kerby2000/SnookerHelpCueTracker/PCB/CueTracker/docs/hardware/source_register.md

# Cue Tracker hardware primary-source register

Date: 2026-07-15

This register records the manufacturer sources used for the hierarchical `rear_main.kicad_sch` / `front_sensor.kicad_sch` design: pin maps, support networks, footprints, protection thresholds, power limits and provisional tuning values.

| Block | Primary source | Applied decision |
|---|---|---|
| ESP32-S3-PICO-1-N8R8 | https://documentation.espressif.com/esp32-s3-pico-1_datasheet_en.pdf | Official LGA56 plus exposed-pad pin map and 7 x 7 mm package; 8 MB Quad-SPI flash, 8 MB Octal-SPI PSRAM, 40 MHz crystal and SiP RF matching are integrated. The external W25Q128 and external 40 MHz network are removed. `-N8R8` ambient rating is -40 to +65 C unless PSRAM ECC is deliberately enabled under Espressif's stated conditions |
| ESP32-S3-PICO-1 CAD provenance | https://github.com/espressif/kicad-libraries | The user-supplied `ESP32-S3-PICO-1-N8R2.zip` was used only for package/STEP geometry common to the PICO-1 family. N8R2 electrical metadata must not be copied into the N8R8 symbol. The project footprint is `CueTracker_Exact:Espressif_ESP32-S3-PICO-1_LGA56_7x7mm_P0.4mm` and the project model is `CueTracker.3dshapes/ESP32-S3-PICO-1-LGA56.step`; pinout and ordering data come from the official N8R8 data sheet |
| ESP32-S3 hardware guidance | https://docs.espressif.com/projects/esp-hardware-design-guidelines/en/latest/esp32s3/schematic-checklist.html | At-least-500-mA 3.3 V source requirement, main-entry bulk capacitance, CHIP_PU/BOOT, native USB and RF layout checks. SiP-specific pin and peripheral implementation remains governed by the PICO-1 data sheet |
| USB data ESD | https://www.st.com/resource/en/datasheet/usblc6-2.pdf | Retained USBLC6-2SC6 dual-line protection on the ESP32-owned USB D+/D- pair. Place it connector-adjacent with short, symmetric data routing and a low-inductance Earth path; do not substitute the earlier PESD5V0Y1BCSF entry without revisiting the symbol, footprint and signal-integrity review |
| VBUS ESD | https://www.ti.com/lit/ds/symlink/esd441.pdf | ESD441-class unidirectional 5 V TVS placed directly beside the USB-C receptacle, before the eFuse, with a short Earth discharge path |
| USB input eFuse/current limiter | https://www.ti.com/lit/ds/symlink/tps25947.pdf | TPS259470A-class reverse-blocking eFuse ahead of BQ25611D. `RILM = 1.10 kOhm`, 1%, targets approximately 3.0 A nominal by TI's programming relation. Validate the exact installed variant, limit tolerance, dV/dt/inrush network, fault timer and thermal response. No 500 mA PPTC remains |
| USB-C CC ESD | https://www.ti.com/lit/ds/symlink/tpd2e2u06.pdf | TPD2E2U06-class dual low-capacitance protection on CC1 and CC2, placed connector-adjacent; it does not replace the TUSB320LAI CC detector |
| TPS63802DLAR | https://www.ti.com/lit/ds/symlink/tps63802.pdf | U5 DLA0010A pin map, true buck-boost topology, 2 A at 3.3 V for input at or above 2.3 V, 0.47 uH, input/output capacitance, feedback and PG implementation |
| TPS63802 power inductor | https://www.coilcraft.com/getmedia/84927b8b-f089-421b-a7f4-a0fa23afe908/xfl4015.pdf | XFL4015-471MEC, 0.47 uH, low DCR and saturation/thermal-current margin |
| USB-C source detector | https://www.ti.com/lit/ds/symlink/tusb320lai.pdf | TUSB320LAIRWBR RWB0012A pin map, fixed-UFP/I2C address `0x47`, orientation and Type-C advertised-current reporting; not USB PD |
| Charger and NVDC power path | https://www.ti.com/lit/ds/symlink/bq25611d.pdf | BQ25611DRTWR RTW0024A pin map, fixed I2C address `0x6B`, 1 uH buck-charger network, NVDC path and TS network. Hardware CE bias makes reset state charge-disabled because the IC register defaults are `CHG_CONFIG=1` and ICHG=1020 mA. Firmware writes `CHG_CONFIG=0` first, keeps `BST_CONFIG=0`, uses 960 mA as the exact step for the 1.0 A R0 policy, and permits 1500 mA only after thermal validation. Charger D+/D- are unused/test pads; ESP32 owns USB D+/D- |
| BQ25611D power inductor | https://www.eaton.com/content/dam/eaton/products/electronic-components/resources/data-sheet/eaton-mpi40-v2-miniature-power-inductors-data-sheet.pdf | L4 MPI4020V2-1R0-R, 1 uH, 6.5 A rated current, 7 A saturation current and 24 mOhm maximum DCR |
| Fuel gauge / mutually exclusive bypass | https://www.ti.com/lit/ds/symlink/bq27427.pdf | BQ27427YZFR YZF0009 pin map, fixed I2C address `0x55`, integrated approximately 7 mOhm sense path and coulomb counting. TI recommends 2 A maximum long-term RMS average utilization, so the gauge is fitted only in the `R0_GAUGE_2A` option. The default `R0_3A` build makes the gauge DNP and fits a 3 A-rated bypass; gauge and bypass must never both be fitted |
| Switched voltage fallback | https://www.ti.com/lit/ds/symlink/tps22919.pdf | U9 TPS22919DCKR disconnects R23/R24 and C34 from PACK_P between samples; GPIO46 drives ON and R25 100 kOhm pulls ON to Earth at reset. GPIO46 is intentionally shared with `SENSOR_PWR_EN`. This is a voltage-only fallback when U14 is omitted |
| Independent battery protector | https://www.ti.com/lit/ds/symlink/bq2980.pdf | BQ298217RUGR fixed 4.250 V OVP / 2.600 V UVP and -36 mV OCC / 60 mV OCD / 200 mV SCD thresholds; nominal approximately 1.8 A charge OC, 3.0 A discharge OC and 10 A short-circuit thresholds with 20 mOhm R44. These `V/R` figures are nominal and require tolerance/temperature validation |
| Protection FET and DMS land | https://www.ti.com/lit/ds/symlink/csd87313dms.pdf | Active CSD87313DMS dual common-drain FET, 100 nA maximum gate leakage, 5.5 mOhm maximum S1-S2 at 4.5 V and 17 A at TC=25 C. Pages 10-11 / pattern 4222980/A define the custom land; CAD-only exposed pads 9=S1 and 10=S2. TI package data lists RoHS Exempt, which is a release-review gate |
| Protection current shunt | https://www.vishay.com/docs/30100/wsl.pdf | R44 WSL2512R0200FEA, 20 mOhm, 1%, 1 W, 2512-class Power Metal Strip; route independent Kelvin sense from the two termination pads and keep `CELL_N_RAW` separate from Earth except through R44 |
| Samsung INR18650-35E reference cell | https://www.18650.rs/uploads/samsung-35e.pdf | Samsung SDI manufacturer specification (document mirror): 1S 18650, 3.6 V nominal, 3350 mAh minimum, 4.20 V charge termination, 1.7 A standard charge, 2.0 A maximum charge and 8 A maximum continuous discharge. R0 intentionally uses 960 mA normal charge and permits 1.5 A only after thermal validation |
| Remote cell NTC | https://www.semitec-global.com/uploads/sites/2/2017/03/P11-12_AT_Thermistor.pdf | TH1 Semitec 103AT-2, 10 kOhm at 25 C, beta 25/85 of 3435 K. TH1 is DNP for PCBA because the schematic component represents solder pads; hand-wire and thermally bond the remote sensor after assembly unless a deliberate, validated BQ25611D `TS_IGNORE` configuration is used |
| Optional 32.768 kHz RTC crystal | https://www.epsondevice.com/crystal/en/products/crystal-unit/fc135r.html | ESP32-S3-PICO-1 integrates the required 40 MHz crystal. The external Epson FC-135R/X1A0001410001 32.768 kHz, 7 pF crystal may remain only on the SiP's `XTAL_32K_P/N` pins when firmware uses the external RTC clock; load capacitors are starting values that require stray-capacitance and start-up validation |
| LSM6DSV320XTR | https://www.st.com/resource/en/datasheet/lsm6dsv320x.pdf | U12 exact LGA-14 pin map, supply support and SPI/I2C interface requirements |
| IIS3DWB10ISTR | https://www.st.com/resource/en/datasheet/iis3dwb10is.pdf | U11 exact 16-pin wettable-flank LLGA pin map and terminal geometry |
| ST MEMS land rules | https://www.st.com/resource/en/technical_note/tn0018-surface-mounting-guidelines-for-mems-sensors--in-an-lga-package--stmicroelectronics.pdf | Manufacturer land-extension guidance for the IIS3DWB10ISTR footprint |
| IIS3DWB10IS reference PCB | https://www.st.com/en/evaluation-tools/steval-mki253ka.html | Official evaluation-board Gerber/CAD resource retained as the independent production-footprint cross-check |
| BMP581 | https://www.bosch-sensortec.com/media/boschsensortec/downloads/datasheets/bst-bmp581-ds004.pdf | U6 exact ten-pin LGA map, I2C address `0x46` straps, local decoupling and pressure-port keepout |
| MMC5983MA | https://www.memsic.com/Public/Uploads/uploadfile/files/20220119/MMC5983MADatasheetRevA.pdf | U8 exact 16-pin map, CAP capacitance and fixed I2C address `0x30` |
| IM73A135V01 microphone | https://www.infineon.com/assets/row/public/documents/24/49/infineon-im73a135-datasheet-en.pdf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 | Exact PG-LLGA-5-2 connection, differential analog output, MICBIAS supply limit and characterized load |
| TLV320ADC6120IRTER | https://www.ti.com/lit/ds/symlink/tlv320adc6120.pdf | U13 exact RTE0020A pin map, differential ADC input through C55/C59 and R39/R43, integrated MICBIAS/PGA/ADC with C51 100 nF and C52 1 uF support, I2C address `0x4E` and I2S output |
| Audio analog-input design | https://www.ti.com/lit/an/sbaa583/sbaa583.pdf | AC-coupling and differential input-interface guidance for the microphone-to-ADC path |
| Audio-supply ferrite | https://www.murata.com/products/productdata/8796738650142/ENFA0003.pdf | BLM18KG601SN1D, 600 Ohm at 100 MHz, high-current DC power-line bead for the audio rail |
| Battery/NTC plated-slot interfaces | Final qualified cell/tab/cradle assembly drawing plus the Samsung and Semitec sources above | Factory-welded cell tabs solder to plated PCB slots rated for at least 3 A normal design current. An insulated cradle and strain relief retain the cell mechanically; solder joints are not structural retention. TH1 remains a DNP-at-PCBA two-pad interface for the required hand-wired remote NTC unless `TS_IGNORE` is deliberately validated |
| CA-C03 populated antenna | https://fccid.io/m/c060d34abf8b55518595b1ab4dcd217b408b40b563f5f039319b2a94e9e23f11.pdf | Manufacturer-authored CrossAir V02 dimensions, 2.4-2.5 GHz performance, board reference and 0 Ohm / 3 nH / 0 Ohm starting match. AE1 CA-C03 is the populated schematic antenna. Its matching network is provisional and requires VNA/OTA tuning in the final stack-up and enclosure |
| KH-3216-H0209 evaluated alternative | https://www.kinghelm.net/upload/file/20240525/KH-3216-H0209-PDF.pdf | 3.23 x 1.66 x 0.45 mm dimensions, 120 MHz minimum bandwidth, reference clearances and matching. It is not interchangeable with CA-C03 and remains an evaluation option only, not a placed DNP component |
| RF ESD | https://assets.nexperia.com/documents/data-sheet/PESD4V0Y1BBSF.pdf | PESD4V0Y1BBSF DSN0603-2 package and low-capacitance RF protection characteristics |
| Front-board 24-position FPC connector | https://www.hirose.com/en/product/p/CL0580-1255-6-50 | Hirose `FH34SRJ-24S-0.5SH(50)`, LCSC `C324726`, 24 positions, 0.5 mm pitch, 0.3 mm FPC/FFC. The user-supplied `FH34SRJ-24S-0.5SH_50_.zip` and `FH34SRJ-24S-0.5SH(50).STEP` were used only as mechanical CAD inputs; the project footprint is `CueTracker_Exact:Hirose_FH34SRJ-24S-0.5SH_50_` and the project model is `CueTracker.3dshapes/FH34SRJ-24S-0.5SH_50_.step`. The exact 24-pin electrical map in `gpio_allocation.md` is normative |
| HMI 8-position FPC connector | https://www.hirose.com/en/product/p/CL0580-1231-8-50 | Hirose `FH34SRJ-8S-0.5SH(50)`, 8 positions, 0.5 mm pitch, 0.3 mm FPC/FFC. The user-supplied `FH34SRJ-8S-0.5SH.zip` was used as mechanical CAD provenance; the project footprint is `CueTracker_Exact:Hirose_FH34SRJ-8S-0.5SH_50_` and the project model is `CueTracker.3dshapes/FH34SRJ-8S-0.5SH_50_.step`. Contact-side and cable-mirroring review remains mandatory |
| ST7789 HMI target | https://www.sitronix.com.tw/en/products/aiot-device-ddi/ | Sitronix identifies ST7789V as a 240 x 320 controller supporting three-/four-line serial interfaces and 3.3 V-class supplies; the selected module exposes a 135 x 240 window. The eight-pin board interface is a project-defined daughterboard contract, not a verified raw-panel pinout. The AliExpress listing/drawing is not primary electrical evidence; confirm the purchased module drawing, controller suffix, backlight current and connector orientation before PCB release |

## Procurement and compliance notes

- Q1 is TI CSD87313DMS, LCSC/JLC catalog identifier **C2863848**. Catalog data is procurement-only; the TI data sheet, package addendum and recommended PCB pattern are authoritative.
- TI lists CSD87313DMS as active/production but marks the package **RoHS Exempt** in the package addendum checked 2026-07-14. Regulatory/procurement approval is required before release.
- The custom Q1 footprint must retain separate exposed source lands 9 and 10 from TI-linked CAD. A generic KiCad VSON/NexFET footprint is not an acceptable substitution.
- The default `R0_3A` assembly fits the 3 A-rated BQ27427 bypass and makes the gauge DNP. The optional `R0_GAUGE_2A` assembly fits BQ27427 and leaves the bypass open. These are mutually exclusive BOM variants.
- Battery plated slots and TH1 pads define PCB interfaces only. TH1 is DNP for automated PCBA, but the remote 103AT-2 is hand-wired and required unless `TS_IGNORE` is deliberately validated. Cell authenticity, factory-tab geometry/material, plated-slot design, cradle, strain relief, insulation and thermistor attachment require an approved assembly drawing.
- The imported Hirose 24-position and 8-position footprints reproduce the supplied copper geometry and use the supplied STEP models. Their current signal pads use full-size 0.30 x 0.80 mm paste openings; reproduce the vendor archive's reduced approximately 0.25 x 0.65 mm paste apertures and explicit solder-mask treatment before production release.

Crystal load capacitors and both RF matching networks are starting values. They are not claimed as production-tuned values. The `Earth` symbol is a user-requested schematic convention for circuit 0 V/battery negative; it does not document a protective-earth connection.
