kerby2000/SnookerHelpCueTracker/PCB/CueTracker/output/renders/png/CueTracker_schematic_page_2.png

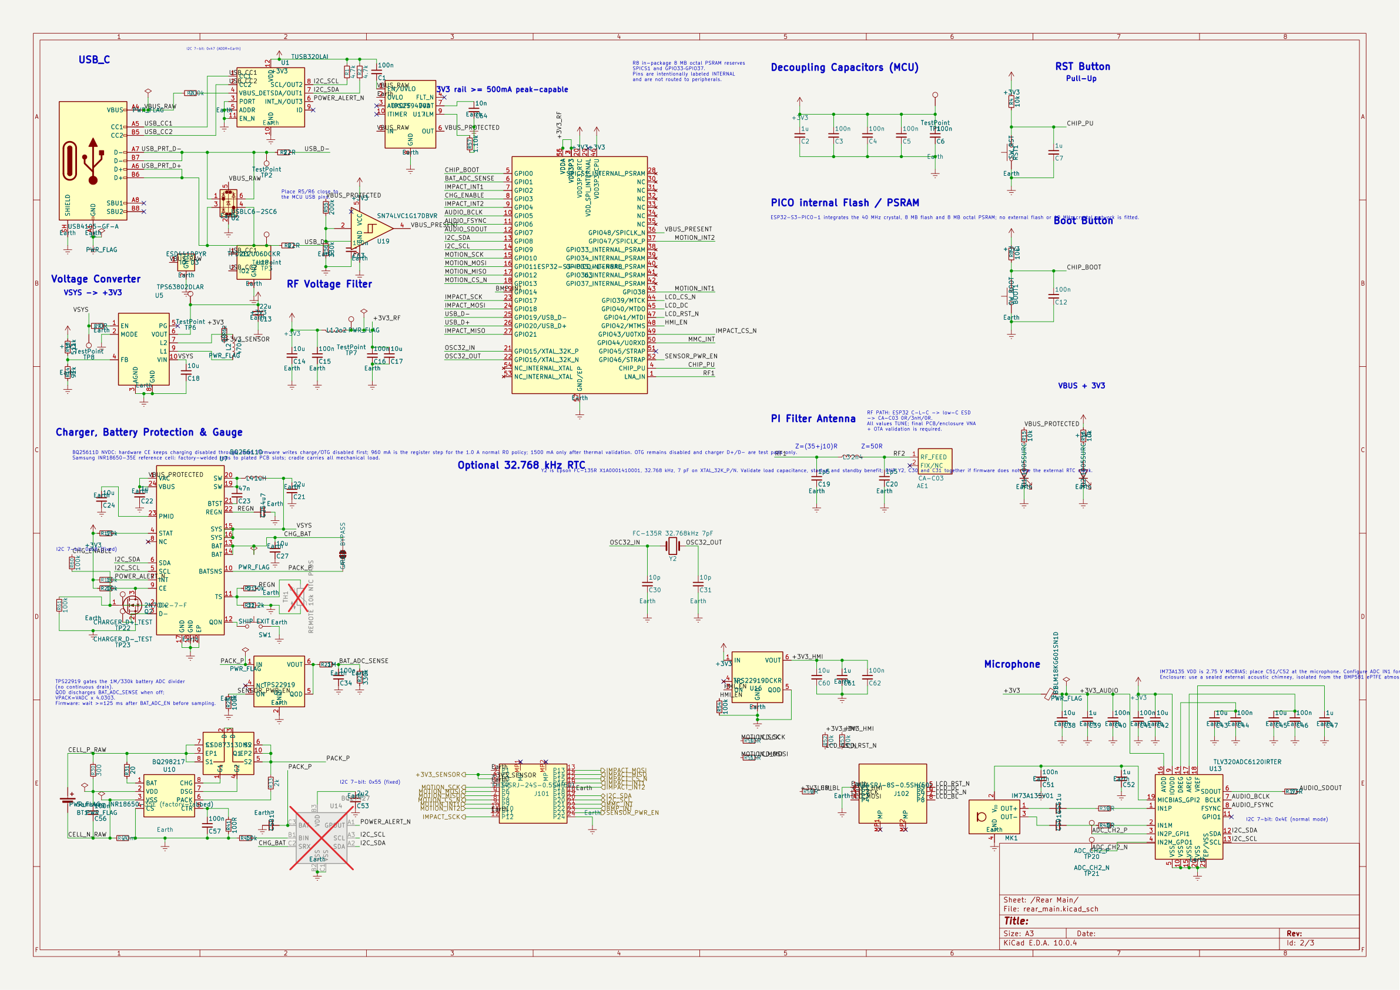
PCB/CueTracker/output/renders/png/CueTracker_schematic_page_2.png
