kerby2000/SnookerHelpCueTracker/PCB/CueTracker/output/pdf/CueTracker_schematic.pdf

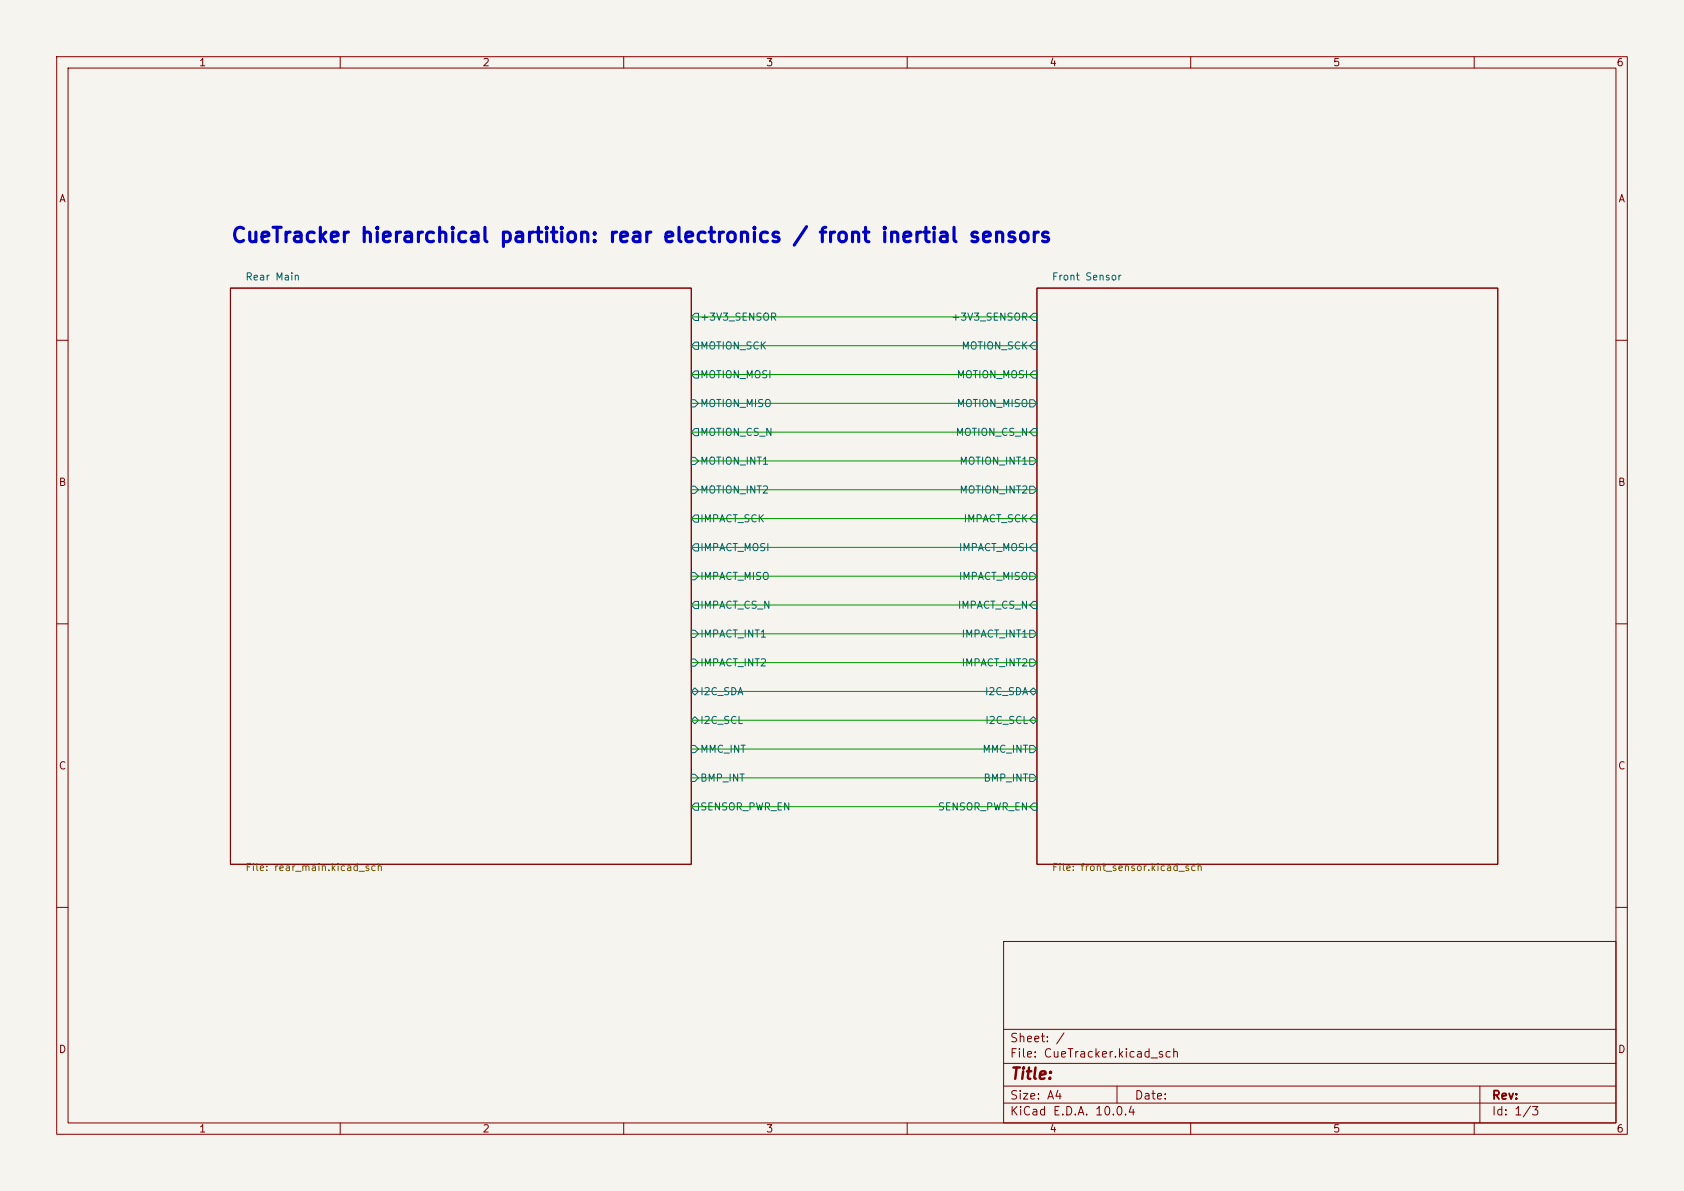
[picture p4: page 1]

Front Sensor File: front_sensor.kicad_sch CueTracker hierarchical partition: rear electronics / front inertial sensors

Size: A4 | Rev:
KiCad E.D.A. 10.0.4 | Id: 1/3

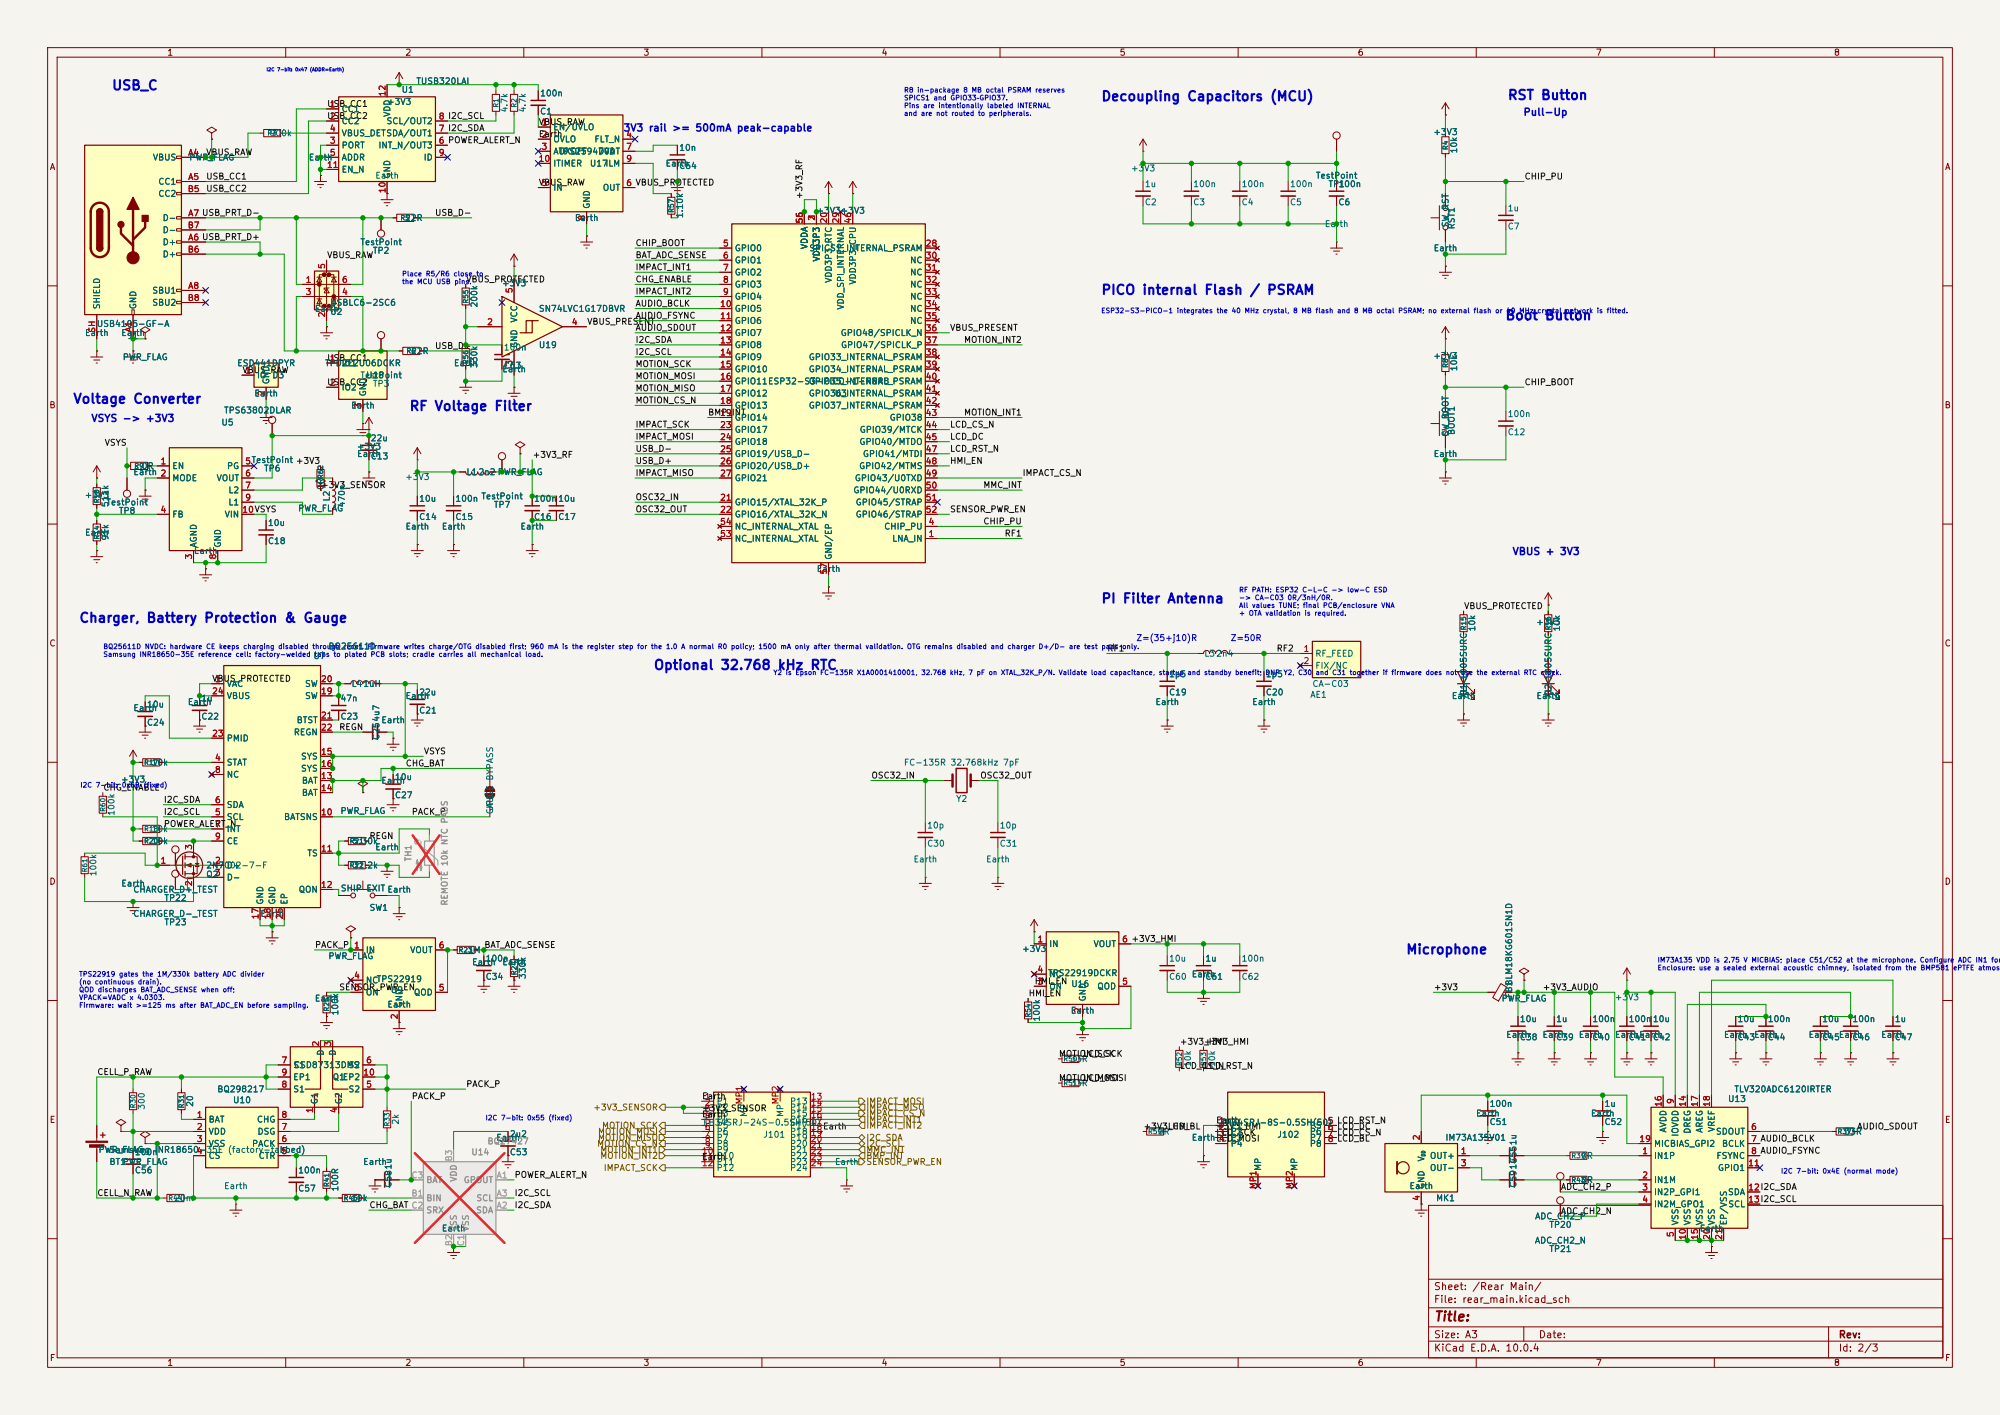
[picture p5: page 2]

PICO internal Flash / PSRAM
VBUS_PRESENT MMC_INT

ESP32-S3-PICO-1 integrates the 40 MHz crystal, 8 MB flash and 8 MB octal PSRAM; no external flash or 40 MHz crystal network is fitted. VBUS + 3V3

SW 19 SW 20 BTST 21 REGN 22 PMID 23

VBUS_PROTECTED

VSYS REGN
TS 11 QON 12 BAT 13 BAT 14

IM73A135 VDD is 2.75 V MICBIAS; place C51/C52 at the microphone. Configure ADC IN1 for the differential microphone path and keep OUT+/OUT- matched. Enclosure: use a sealed external acoustic chimney, isolated from the BMP581 ePTFE atmospheric vent. ADC channel 2 is routed to TP20/TP21 for test or optional expansion.

TPS22919 gates the 1M/330k battery ADC divider
(no continuous drain). QOD discharges BAT_ADC_SENSE when off; VPACK=VADC x 4.0303. Firmware: wait >=125 ms after BAT_ADC_EN before sampling.

Size: A3 | Rev:

F Date:

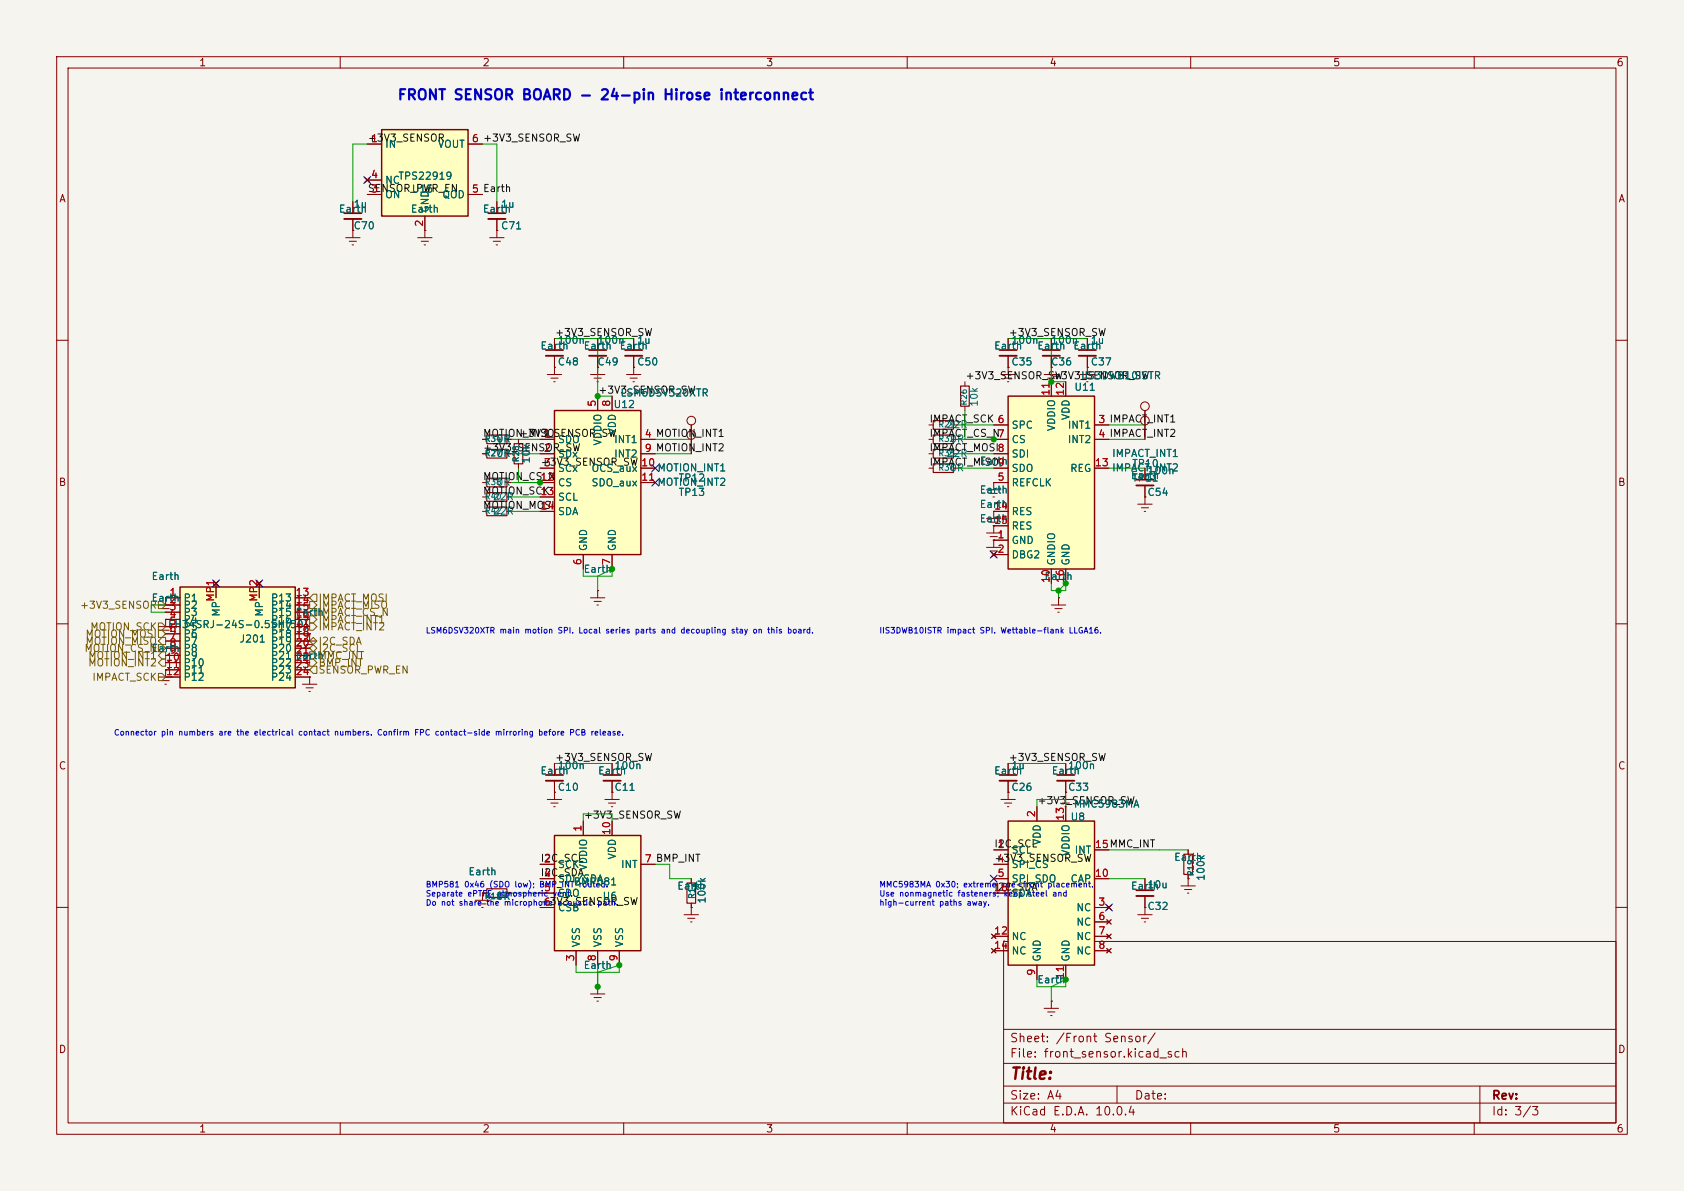
[picture p6: page 3]

FRONT SENSOR BOARD - 24-pin Hirose interconnect

R380R | SCL 13
R4022R | SDA 14

high-current paths away. J201

9 CAP 10 GND 11 NC 12 VDDIO 13 NC 14

MMC5983MA 0x30; extreme cue-front placement. Use nonmagnetic fasteners; keep steel and
