kerby2000/SnookerHelpCueTracker/PCB/CueTracker/CueTracker.kicad_pcb

## KiCad design breakout.kicad_sch

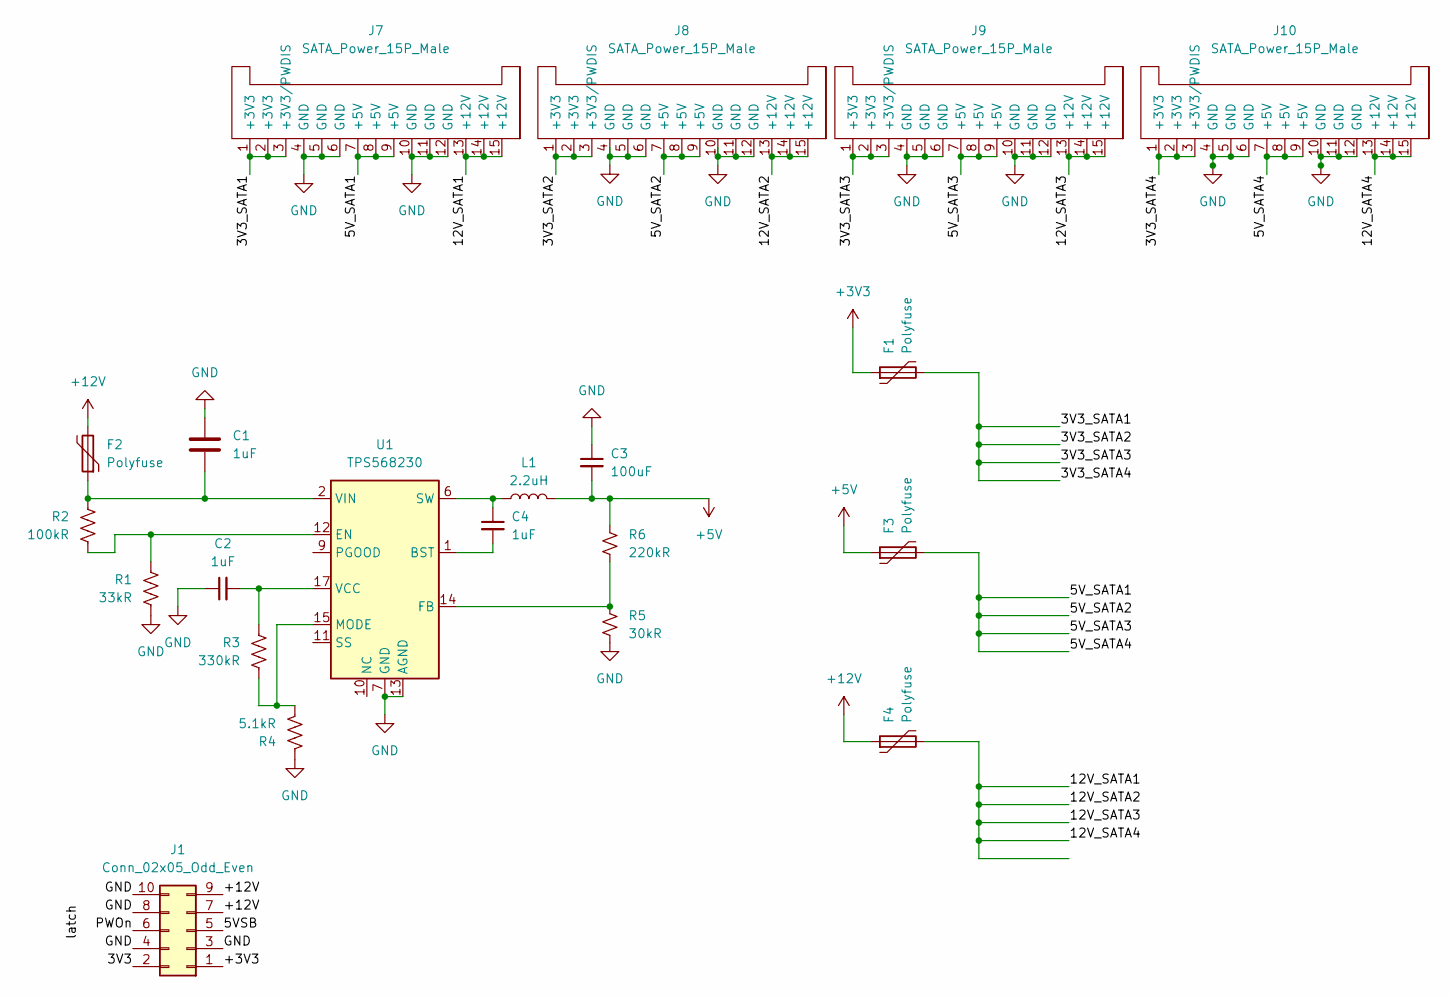
[picture p7: schematic breakout.kicad_sch]

Parts:
C1, C2, C4: 1uF
C3: 100uF
F1, F2, F3, F4: Polyfuse
J1: Conn_02x05_Odd_Even
J7, J8, J9, J10: SATA_Power_15P_Male; SATA_Power_15P_Male_Angled_THT
L1: 2.2uH
R1: 33kR
R2: 100kR
R3: 330kR
R4: 5.1kR
R5: 30kR
R6: 220kR
U1: TPS568230; Texas_RJE0020A_VQFN-20-1EP_3x3mm_P0.45mm_EP0.675x0.76mm

Connections:
3V3: J1.2
3V3_SATA1: F1.2, J7.1 (+3V3), J7.2 (+3V3), J7.3 (+3V3/PWDIS), J8.1 (+3V3), J8.2 (+3V3), J8.3 (+3V3/PWDIS), J9.1 (+3V3), J9.2 (+3V3), J9.3 (+3V3/PWDIS), J10.1 (+3V3), J10.2 (+3V3), J10.3 (+3V3/PWDIS)
5VSB: J1.5
5V_SATA1: F3.2, J7.7 (+5V), J7.8 (+5V), J7.9 (+5V), J8.7 (+5V), J8.8 (+5V), J8.9 (+5V), J9.7 (+5V), J9.8 (+5V), J9.9 (+5V), J10.7 (+5V), J10.8 (+5V), J10.9 (+5V)
12V_SATA1: F4.2, J7.13 (+12V), J7.14 (+12V), J7.15 (+12V), J8.13 (+12V), J8.14 (+12V), J8.15 (+12V), J9.13 (+12V), J9.14 (+12V), J9.15 (+12V), J10.13 (+12V), J10.14 (+12V), J10.15 (+12V)
+3V3: F1.1, J1.1
+5V: C3.2, F3.1, L1.2, R6.1
+12V: F2.2, F4.1, J1.7, J1.9
GND: C1.1, C2.1, C3.1, J1.3, J1.4, J1.8, J1.10, J7.4 (GND), J7.5 (GND), J7.6 (GND), J7.10 (GND), J7.11 (GND), J7.12 (GND), J8.4 (GND), J8.5 (GND), J8.6 (GND), J8.10 (GND), J8.11 (GND), J8.12 (GND), J9.4 (GND), J9.5 (GND), J9.6 (GND), J9.10 (GND), J9.11 (GND), J9.12 (GND), J10.4 (GND), J10.5 (GND), J10.6 (GND), J10.10 (GND), J10.11 (GND), J10.12 (GND), R1.2, R4.1, R5.2, U1.7 (GND), U1.8 (GND), U1.13 (AGND), U1.18 (GND), U1.21 (GND)
unnamed: C1.2, F2.1, R2.1, U1.2 (VIN), U1.3 (VIN), U1.4 (VIN), U1.5 (VIN)
unnamed: C2.2, R3.1, U1.17 (VCC)
unnamed: C4.1, L1.1, U1.6 (SW), U1.19 (SW), U1.20 (SW)
unnamed: C4.2, U1.1 (BST)
unnamed: R1.1, R2.2, U1.12 (EN)
unnamed: R3.2, R4.2, U1.15 (MODE)
unnamed: R5.1, R6.2, U1.14 (FB)
unnamed: U1.10 (NC), U1.16 (NC)
PWOn: J1.6
