kerby2000/SnookerHelpCueTracker/PCB/CueTracker/CueTracker.kicad_pcb

## KiCad design _restore_backup_2026-08-21T09-53-34-952/sata_power.sch

Schematic: sata_power.sch

Parts:
C1, C2: 100uF; C_1210_3225Metric
C3, C4: 330uF; C_7343-31
D1, D2: 1N5822; D_SMA
J1: SATA_POWER; SATA_Power_15P_Horizontal
J2: 12V_INPUT; PinHeader_1x02_P2.54mm_Vertical
L1: 68uH; L_10x10mm_H10
L2: 47uH; L_10x10mm_H10
PWR01, PWR08, PWR15: +12V
PWR02, PWR04, PWR05, PWR06, PWR07, PWR09, PWR11, PWR12, PWR13, PWR14, PWR16: GND
PWR03: +5V
PWR10: +3V3
R1: 3.09k; R_0805_2012Metric
R2, R4: 1.00k; R_0805_2012Metric
R3: 1.68k; R_0805_2012Metric
U1: LM2596S-ADJ 5V; TO-263-5_TabPin3
U2: LM2596S-ADJ 3V3; TO-263-5_TabPin3

Notes on the sheet:
SATA power from 12 V input: pass 12 V directly; generate regulated 5 V and 3.3 V rails.
U1: LM2596S-ADJ, nominal 5 V / 3 A. R1=3.09k, R2=1.00k (Vref ~1.23 V).
U2: LM2596S-ADJ, nominal 3.3 V / 3 A. R3=1.68k, R4=1.00k (Vref ~1.23 V).
D1/D2 are catch diodes; verify inductor, capacitor ripple-current, thermal, and load ratings against the drive.
Input protection, fuse/current limiting, reverse-polarity protection, and USB-PD source negotiation are external to this sheet.
