kerby2000/SnookerHelpCueTracker/PCB/CueTracker/CueTracker.kicad_pcb

## KiCad design _restore_backup_2026-08-29T22-07-09-390/breakout.kicad_sch

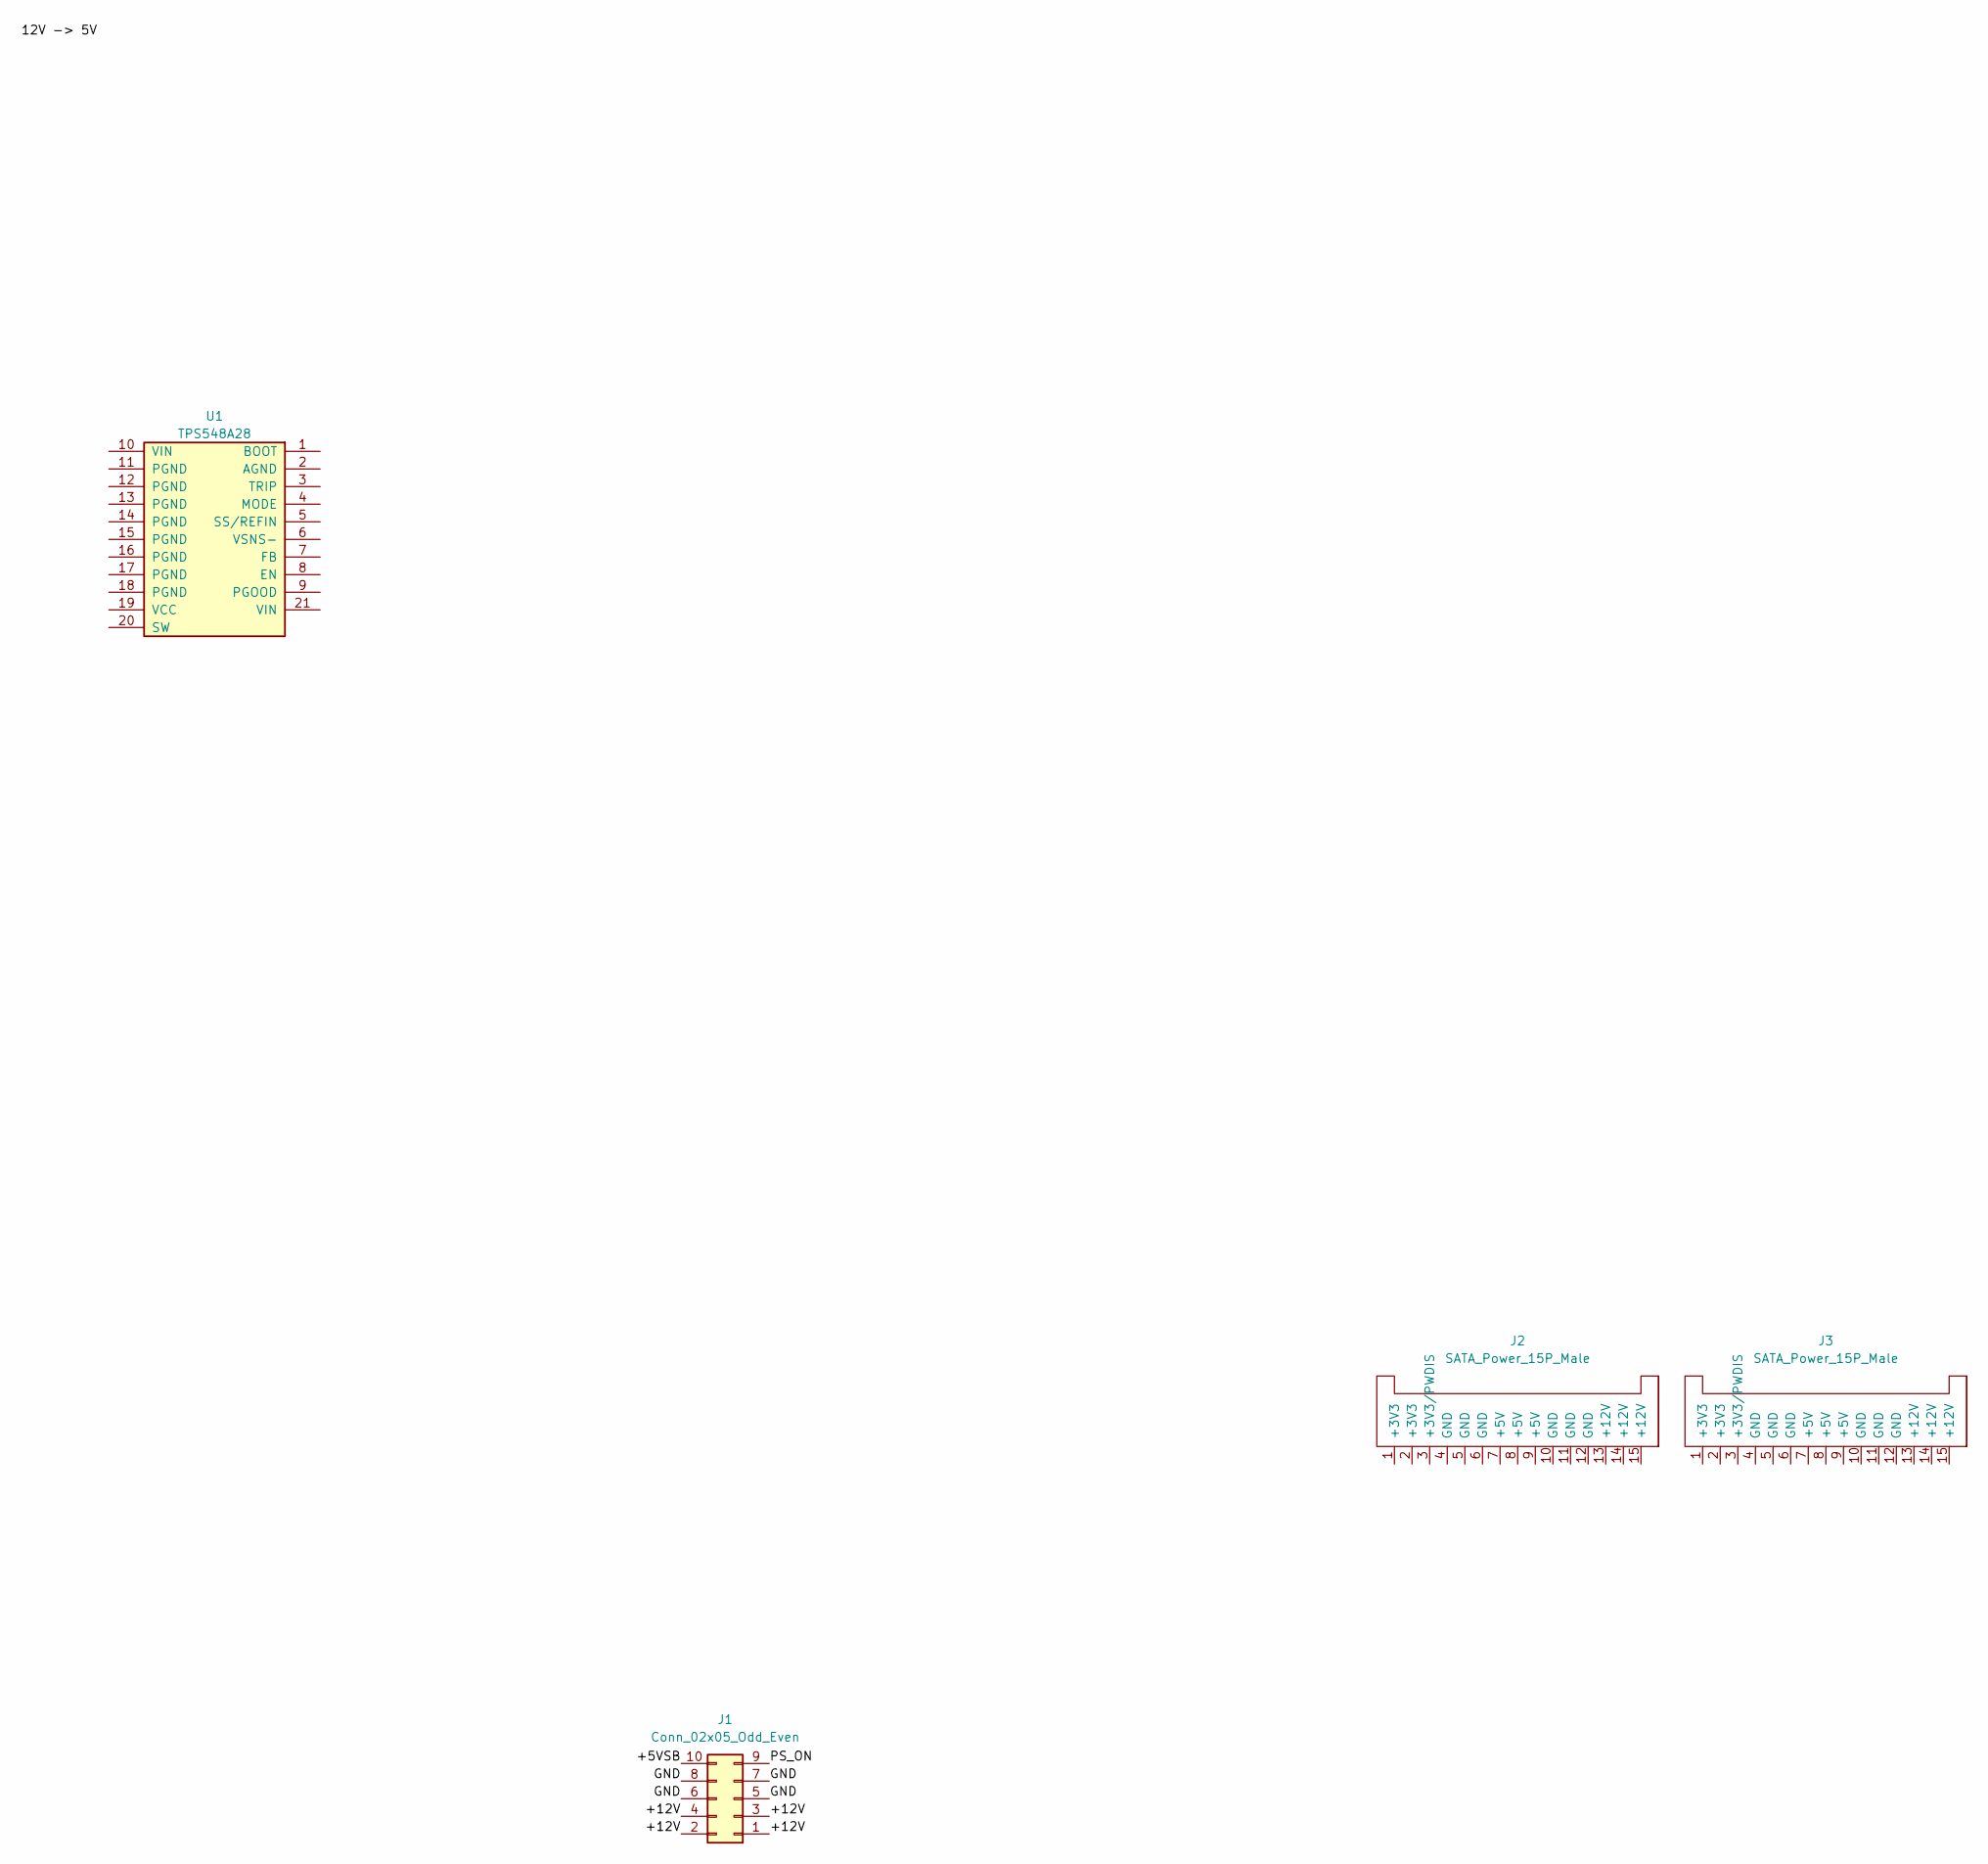
[picture p8: schematic breakout.kicad_sch]

Parts:
J1: Conn_02x05_Odd_Even
J2, J3: SATA_Power_15P_Male; SATA_Power_15P_Male_Angled_THT
U1: TPS548A28; TI_RWW0021A_VQFN-HR-21_4x3mm_P0.4mm

Connections:
+5VSB: J1.10
+12V: J1.1, J1.2, J1.3, J1.4
GND: J1.5, J1.6, J1.7, J1.8
PS_ON: J1.9
