kerby2000/SnookerHelpCueTracker/(commit log)

2026-07-14 pcb: preserve CueTracker schematic baseline
    [CueTracker.kicad_pcb, CueTracker.kicad_sch, bom_manufacturing.csv, gpio_allocation.csv]
2026-07-14 pcb: migrate CueTracker to split PICO architecture
    [CueTracker.kicad_sch, CueTracker_bom.csv, bom_manufacturing.csv, front_sensor.kicad_sch, gpio_allocation.csv, rear_main.kicad_sch]
2026-07-16 pcb: clean up CueTracker split
    [CueTracker.kicad_sch, front_sensor.kicad_sch, rear_main.kicad_sch]
